baguenaaaron-cloud/Symmetric-Power-Supply-15V/Schematic.jpeg

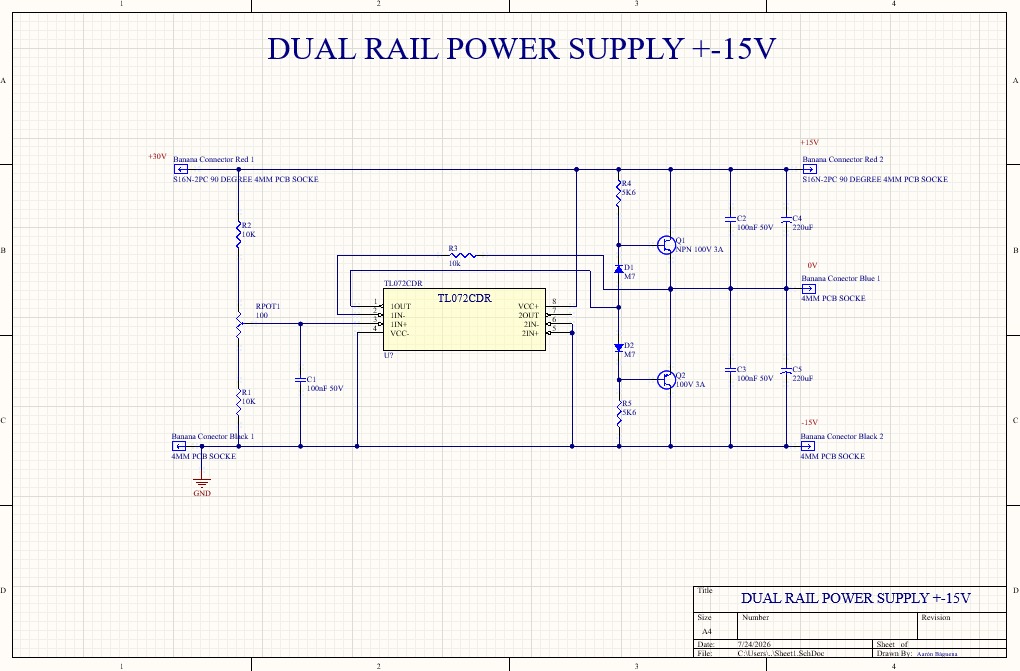
Schematic.jpeg
