baguenaaaron-cloud/Symmetric-Power-Supply-15V/Symmetric_PowerSupply.asc

C1: cap; 0.1µ; V=35 Irms=0 Rser=0 Lser=0
C2: cap; 220µ; V=50
C3: cap; 220µ; V=50
C4: cap; 0.1µ; V=50
C5: cap; 0.1µ; V=50
D1: diode
D2: diode
Q1: npn
Q2: pnp
R1: res; 10000
R2: res; 10000
R3: res; 10000
R4: res; 5600
R5: res; 5600
R6: res; 10000
U1: opamp2; TL072
V1: voltage; 30
Named nets: 0
.lib C:\\Users\\Aarón\\Desktop\\Universidad\\LTspice\\TL072\\TL072.301
.tran 0 10m 0 10u
