baguenaaaron-cloud/Symmetric-Power-Supply-15V/(commit log)

2026-07-24 Add README for symmetric ±15V power supply project
    Added detailed documentation for the symmetric ±15V power supply project, including specifications, circuit description, PCB design, measurements, known limitations, and tools used.
2026-07-24 Remove Gerber files availability note
    Removed mention of Gerber files availability in README.
2026-07-24 Fix image paths in README.md
    Updated image paths for PCB render and layout in README.
2026-07-24 Fix image filename case for 2D layout in README
